xsnrg/AntennaSwitcher/public/hardware/at14-kit.jpg

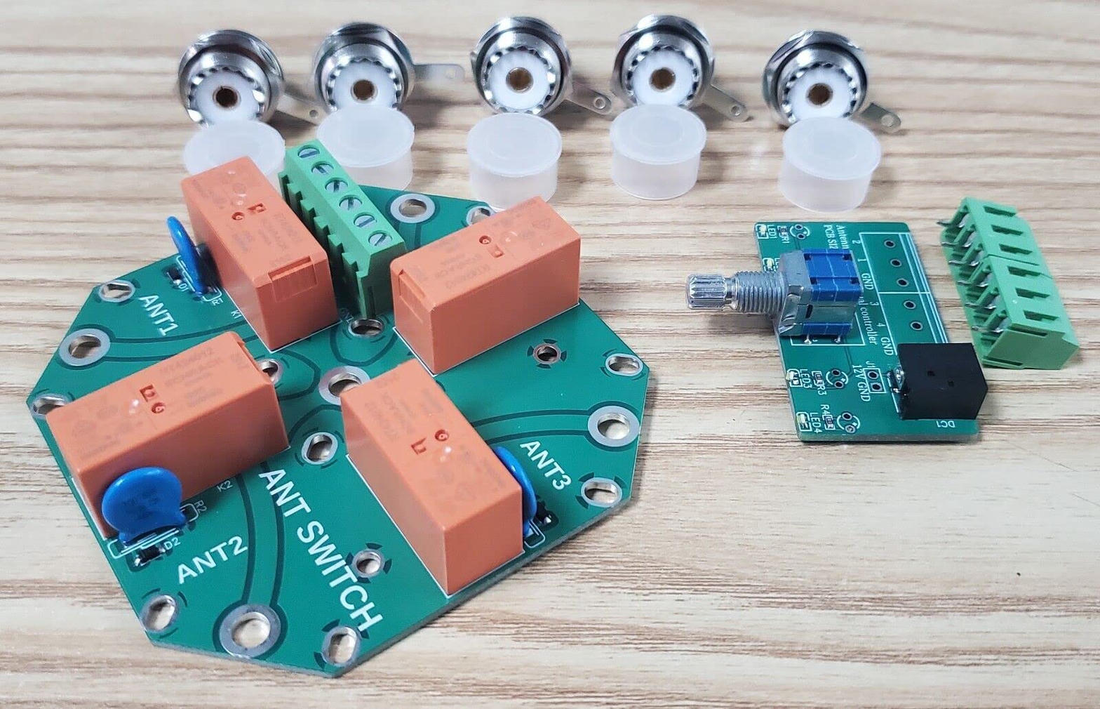
public/hardware/at14-kit.jpg
