xsnrg/AntennaSwitcher/public/hardware/esp32-enclosure.jpg

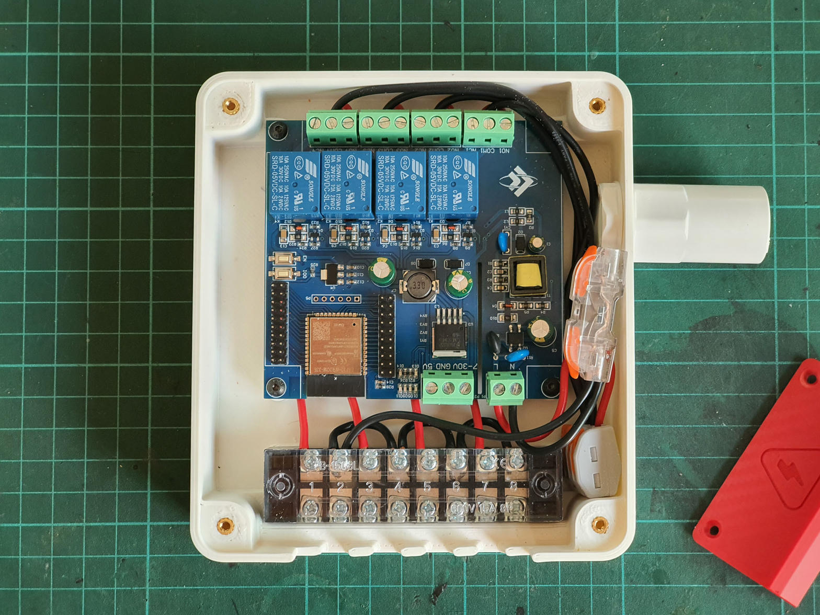
public/hardware/esp32-enclosure.jpg
