xsnrg/AntennaSwitcher/public/hardware/at14-switch.jpg

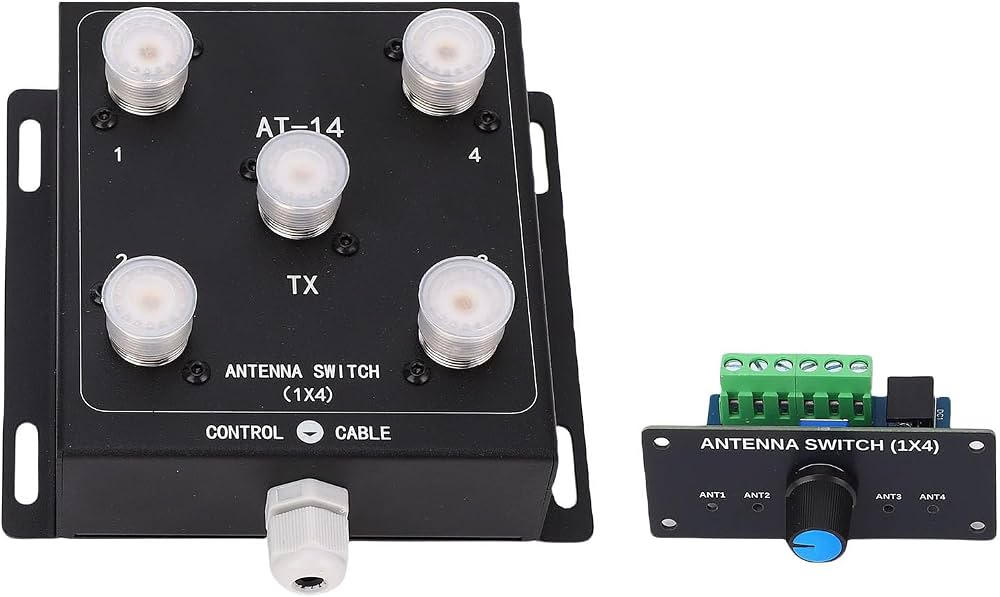
public/hardware/at14-switch.jpg
