xsnrg/AntennaSwitcher/public/hardware/esp32-relay-board.jpg

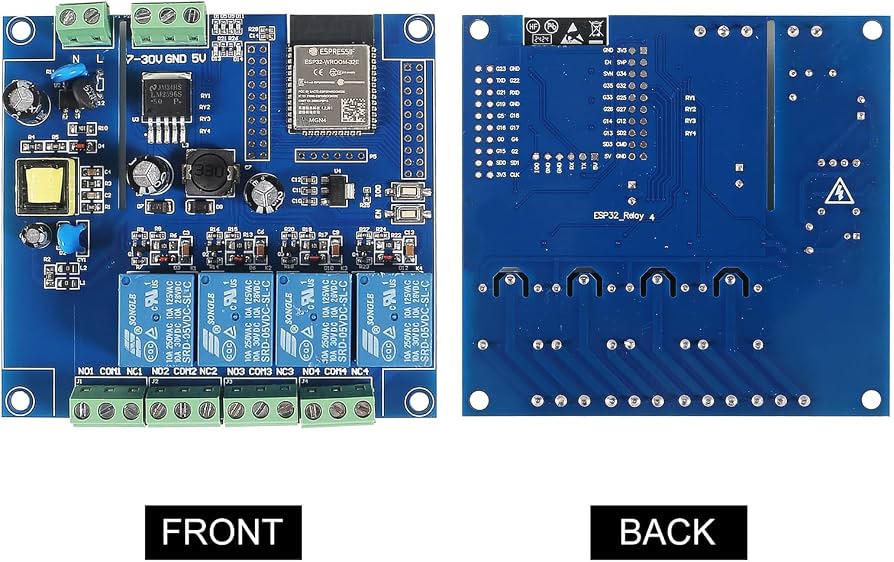
public/hardware/esp32-relay-board.jpg
