xsnrg/AntennaSwitcher/public/og.jpg

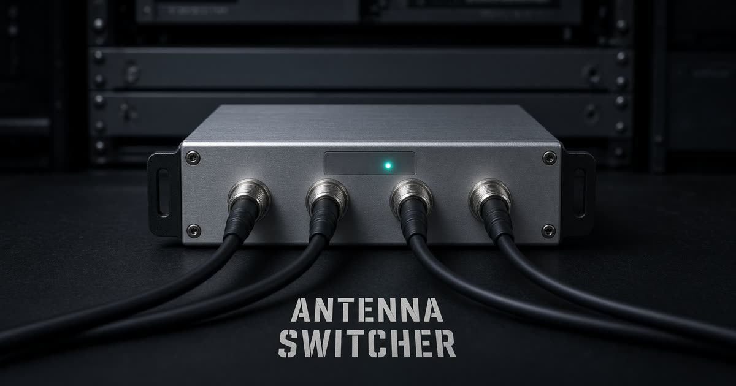
public/og.jpg
