xsnrg/AntennaSwitcher/(commit log)

2026-09-02 Add ESP32 firmware and full hardware research notes
2026-09-02 Add DC supply, die temp, and WiFi RSSI to the control page
2026-09-02 Drop VIN divider; show 3.3 V brownout status instead of a fake voltmeter
    [AntennaSwitcher.ino]
2026-09-02 Sync lab console, tests, and hardware photos with the firmware
    The GitHub repo now has the browser lab (Switch / Wiring / Hardware /
    Firmware), e2e and unit tests, product photos, and the ESP32 sketch so
    the two stay in lockstep.
2026-09-23 Fix QA bugs; add host test harness and API test suite
    Firmware:
    - Escape port names and lastError in the embedded UI (stored XSS)
    - Rename/theme validation errors no longer trip failsafe(); they report
    via noteError() and leave the RF path on its current port
    - parseJsonString decodes JSON escapes and tolerates whitespace after ':'
    - Trim split UTF-8 tails after the 32-byte name cap so stateJson stays valid
    - /api/theme rejects invalid values with 400; add OPTIONS for /api/fault
    - Keep focus and in-progress text in rename inputs across the 1s refresh
    Test:
    - test/harness: compile the real sketch against host stubs (HTTP + GPIO log)
    - test/api_test.py: 20 tests covering boot, break-before-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
    [AntennaSwitcher.ino, api_test.py]
